Kanga2050/t-shirt-cannon/docs/air_and_wiring.png

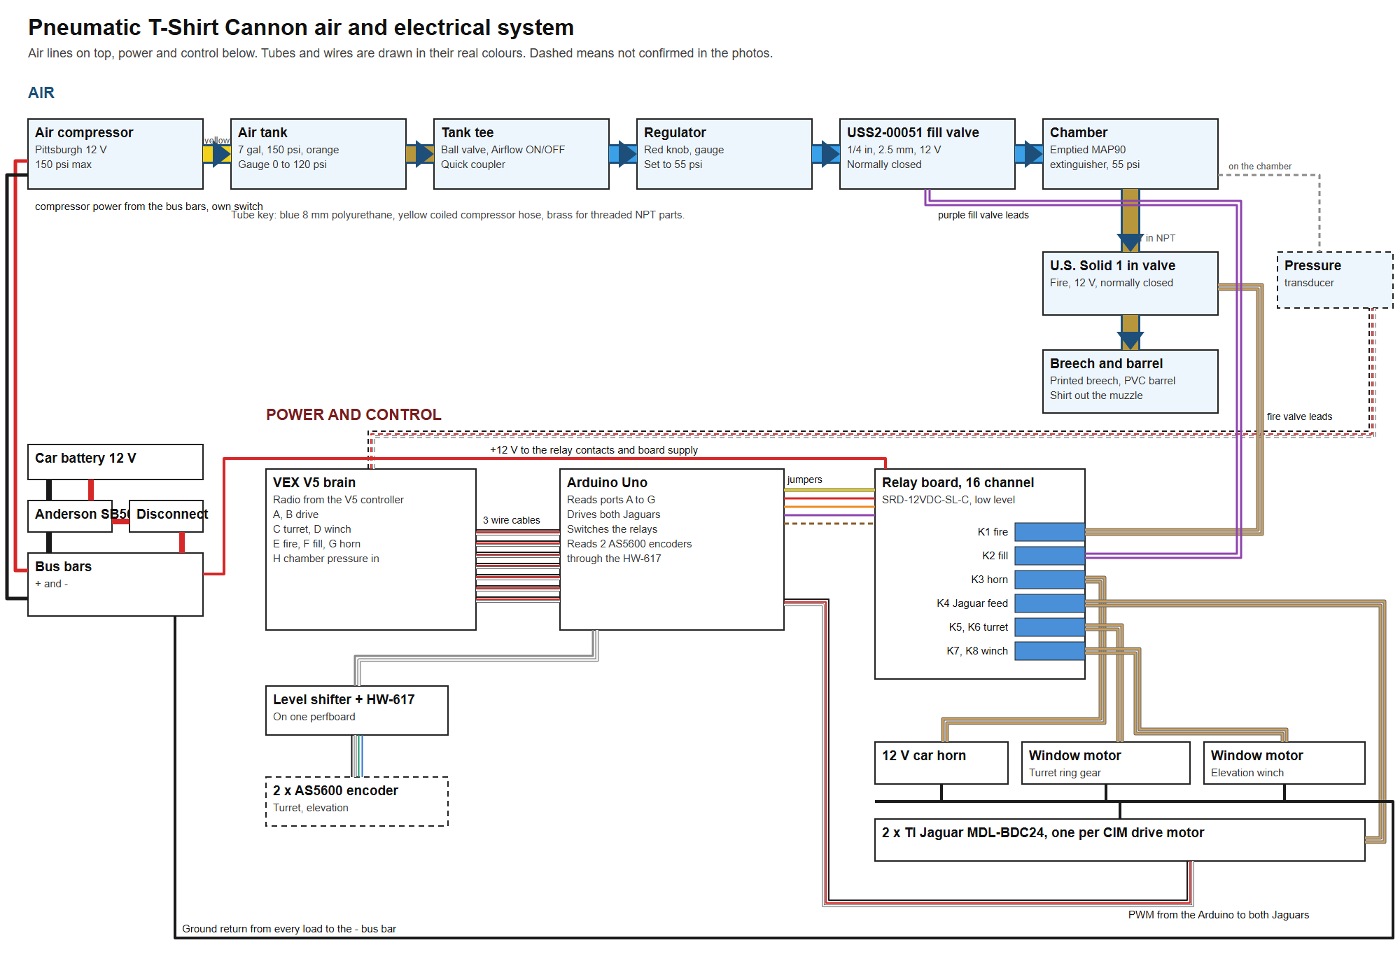
docs/air_and_wiring.png
