Kanga2050/t-shirt-cannon/docs/wiring.png

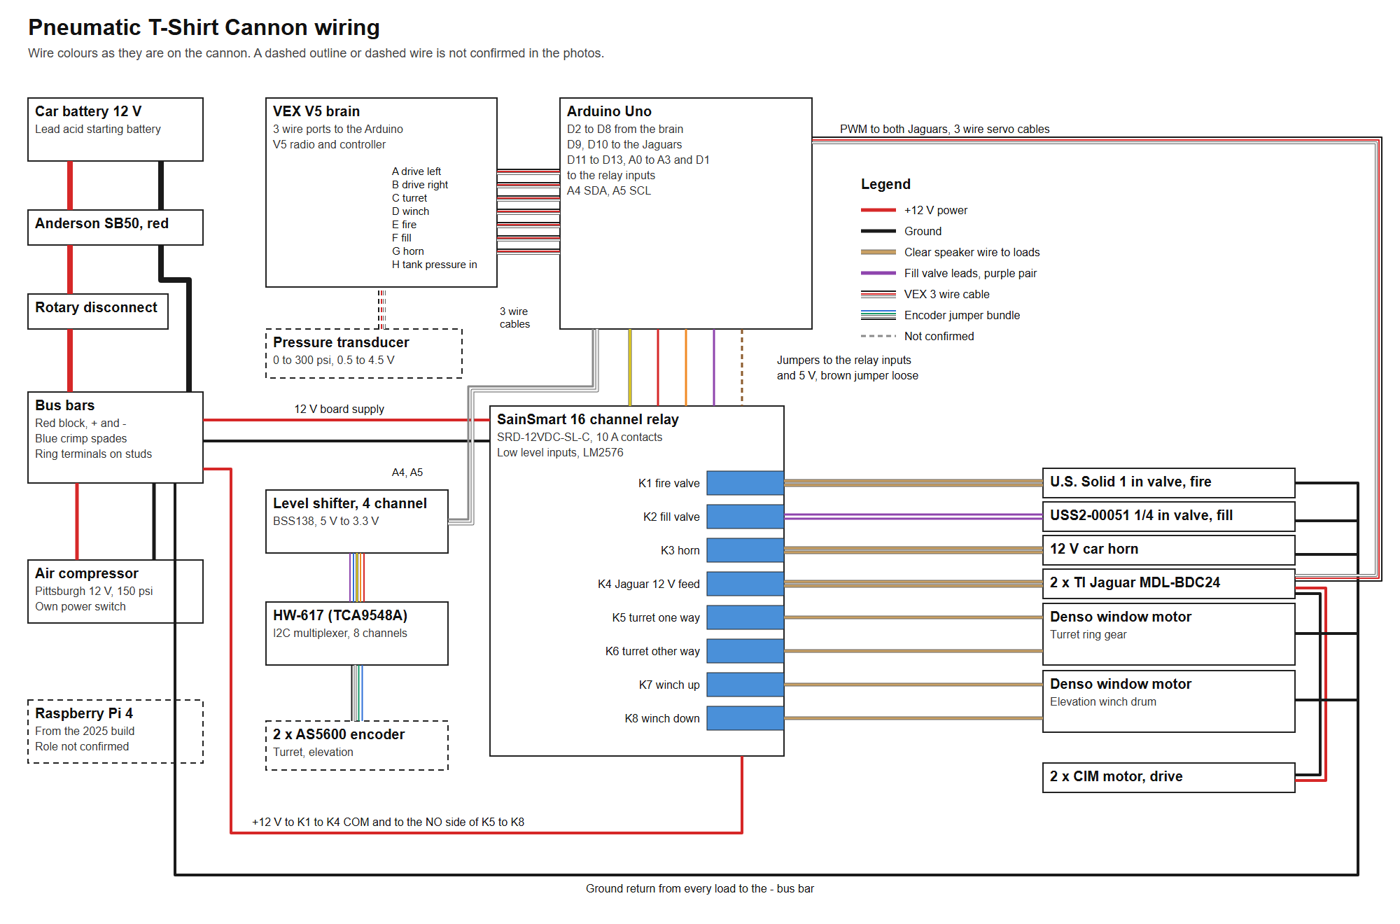
docs/wiring.png
