Kanga2050/t-shirt-cannon/(commit log)

2025-08-16 VEX V5 radio control with Arduino relay and Jaguar driver
    Replace the Pi/Bluetooth control path with a V5 brain and controller.
    The brain sends drive, turntable and winch as 3-wire PWM and the fire
    and horn lines as digital outputs, and reads tank pressure on port H.
    An Arduino Uno decodes the ports, drives both Jaguars and the 16-channel
    relay board, and cuts Jaguar power and every relay if the link drops.
    Move the original Pi code into pi/.
2026-04-11 Match the code to the cannon's wiring: single fire valve, fill valve, encoder soft limits, wiring diagram
2026-10-15 Cleaner wiring diagram and combined air and wiring diagram
